igorwolfs/kicad_libs/README.md

# IW Kicad Library
Library symbols and footprints for kicad.
