igorwolfs/kicad_libs/cad/TF-01A.STEP

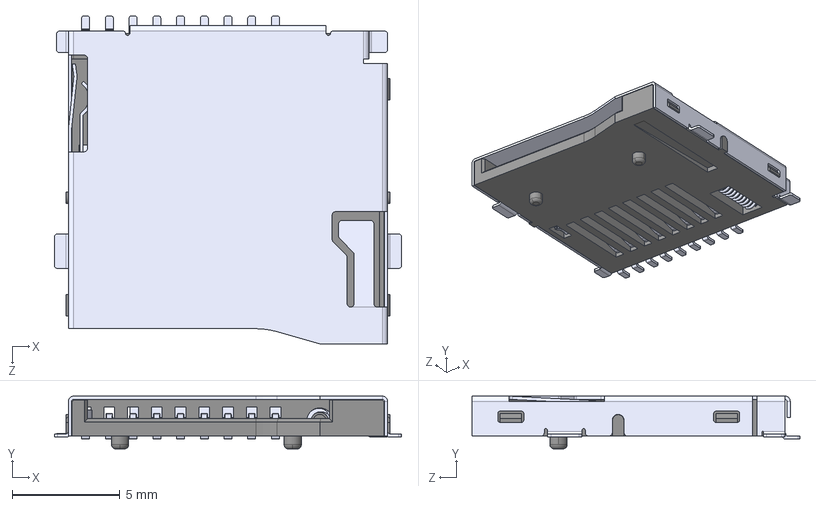
[picture p1: CAD file, 2025-10-25]
cad/TF-01A.STEP
16.1 x 2.45 x 15.2 mm
