igorwolfs/kicad_libs/cad/W9825G6KH-6.step

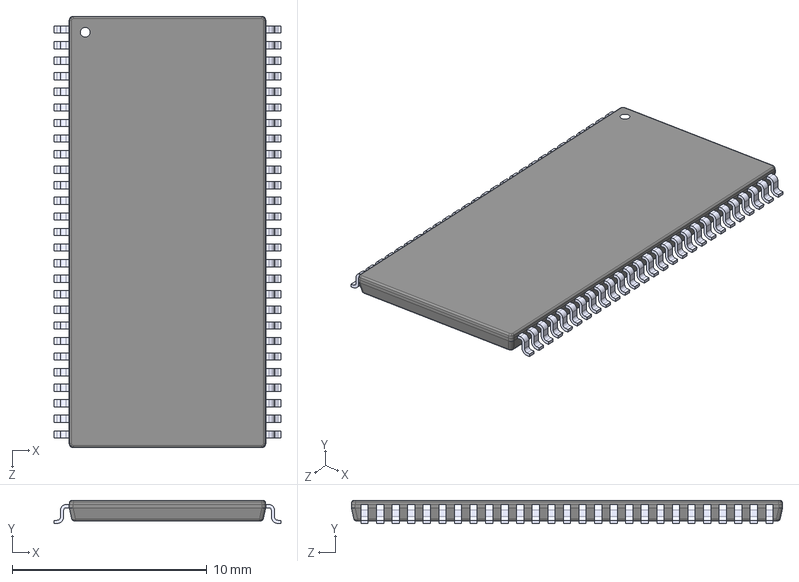
[picture p2: CAD file, 2025-10-11]
cad/W9825G6KH-6.step
11.7 x 1.20 x 22.2 mm
