igorwolfs/kicad_libs/cad/PinSocket_2x06_P2.54mm_Horizontal.step

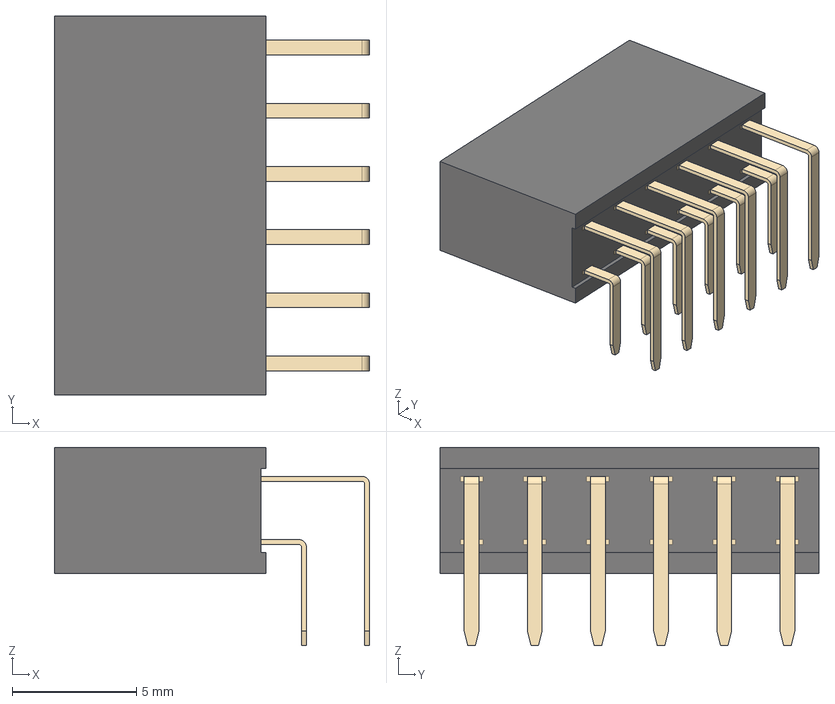
[picture p3: CAD file, 2025-08-07]
cad/PinSocket_2x06_P2.54mm_Horizontal.step
12.7 x 15.2 x 7.98 mm
