igorwolfs/kicad_libs/cad/FBGA96_8X14_MRN.step

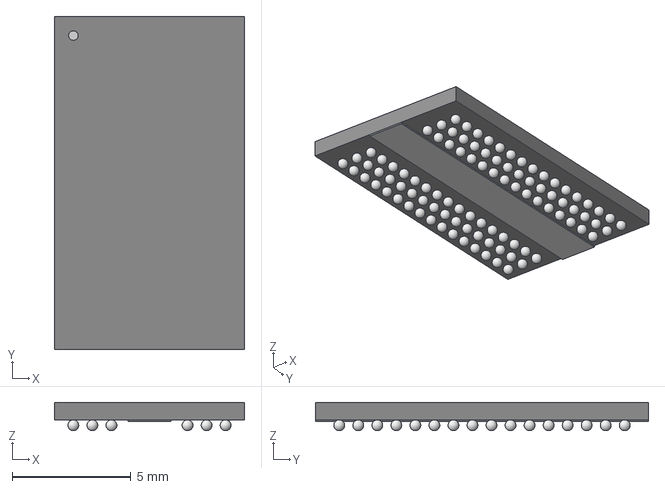
[picture p4: CAD file, 2025-08-07]
cad/FBGA96_8X14_MRN.step
8.00 x 14.0 x 1.20 mm
