igorwolfs/kicad_libs/cad/HRO  TYPE-C-31-M-12.step

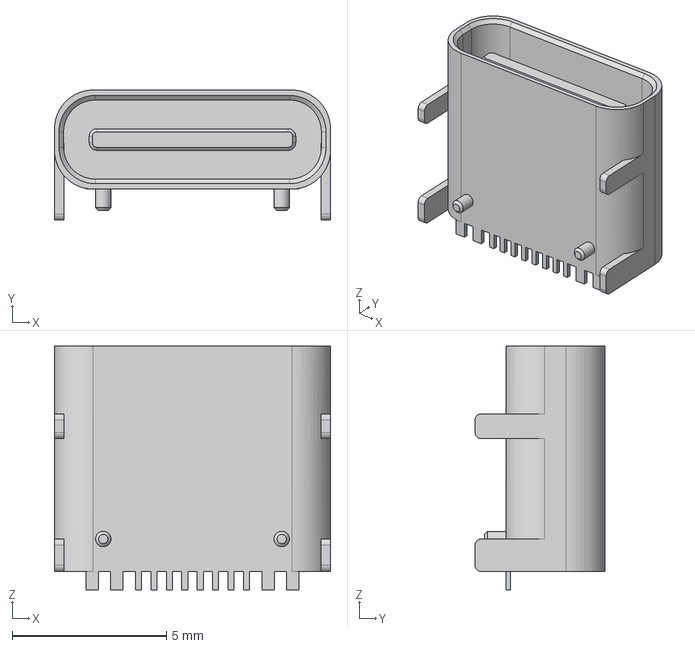
[picture p5: CAD file, 2025-08-07]
cad/HRO TYPE-C-31-M-12.step
8.94 x 4.21 x 7.90 mm
