igorwolfs/kicad_libs/(commit log)

2025-06-10 Added symbols and footprints from acoustic carrier board
2025-06-10 [iw-power] Added power symbols
2025-06-15 [connector] Changed RJ45-connector footprint appropriately
2025-06-27 [iw-connector] Added pmod connector
2025-07-07 [iw-misc] Added button footprint
2025-07-15 [iw-connector] Modified RJ45-footprint
2025-07-17 added connector symbol+footprint and power symbols
2025-07-31 added inductor and hal-sensor footprints
2025-07-31 added inductor symbols, changed hal-sensor symbol
2025-08-07 Added several step file
    [FBGA96_8X14_MRN.step, HRO TYPE-C-31-M-12.step, PinSocket_2x06_P2.54mm_Horizontal.step]
2025-10-09 added hirose connectors
2025-10-11 added SDRAM
    [W9825G6KH-6.step]
2025-10-12 added fpga symbol (next) connect with appropriate footprint
2025-10-25 added 80-pin HRS connector + TF01A
    [TF-01A.STEP]
