igorwolfs/kicad_libs/(notices)

Notices in the files:
cad/PinSocket_2x06_P2.54mm_Horizontal.step:
Copyright (C) 2024, KiCAD
This work is licensed under the
[Creative Commons CC-BY-SA 4.0 License](https://creativecommons.org/licenses/by-sa/4.0/legalcode),
with the following exception:
project files under this or any other license agreement. However, if you wish to distribute
